ian-ross/solder-snorter/README.md

# Solder Snorter: a PC fan solder fume extractor

*Solder Snorter* is a project I used to learn a little about battery
charging and power conversion. You can read about it
[here](https://www.skybluetrades.net/projects/solder-snorter).

Designed with [KiCad](https://kicad-pcb.org/).
