ian-ross/solder-snorter/solder-snorter-bom.ods

Reference | Quantity | Order Qty | Value | Footprint | Datasheet | MPN
BT1 | 1 | 6 | Battery_Cell | solder-snorter:BatteryHolder_Keystone_54_1x18650 | https://www.mouser.at/datasheet/2/215/4-745936.pdf | Keystone 54 (x 2)
C1 C2 | 2 | 20 | 4.7U | Capacitor_SMD:C_0805_2012Metric_Pad1.15x1.40mm_HandSolder | https://www.mouser.at/datasheet/2/210/WTC_MLCC_General_Purpose-1534899.pdf | 0805X475M250CT
C3 | 1 | 20 | 2.2U | Capacitor_SMD:C_0805_2012Metric_Pad1.15x1.40mm_HandSolder | https://www.mouser.at/datasheet/2/210/WTC_MLCC_General_Purpose-1534899.pdf | 0805X225M160CT
C4 | 1 | 20 | 10U | Capacitor_SMD:C_0805_2012Metric_Pad1.15x1.40mm_HandSolder | https://www.mouser.at/datasheet/2/212/KEM_C1006_X5R_SMD-1103249.pdf | C0805C106K4PAC
D1 D2 | 2 |  | LED | LED_SMD:LED_0805_2012Metric_Pad1.15x1.40mm_HandSolder | ~
J1 | 1 | 5 | USB_B_Micro | solder-snorter:USB_Micro-B_Amphenol_10118194-0001LF | https://cdn.amphenol-icc.com/media/wysiwyg/files/drawing/10118194.pdf | 10118194-0001LF
L1 | 1 | 3 | 10U | solder-snorter:L_Murata_FDSD0420-H-100M | https://search.murata.co.jp/Ceramy/image/img/P02/J(E)TE243B-0001_FDSD0420_reference.pdf | FDSD0420-H-100M=P3
M1 | 1 | 1 | Fan | Connector_PinSocket_2.54mm:PinSocket_1x02_P2.54mm_Vertical | https://www.mouser.at/datasheet/2/670/cfm-80v-1776226.pdf | CFM-8025V-132-330
R1 | 1 | 10 | 470 | Resistor_SMD:R_0805_2012Metric_Pad1.15x1.40mm_HandSolder | https://www.mouser.at/datasheet/2/427/crcwce3-1762584.pdf | CRCW0805470RFKEAC
R2 | 1 | 10 | 2K | Resistor_SMD:R_0805_2012Metric_Pad1.15x1.40mm_HandSolder | https://www.mouser.at/datasheet/2/427/crcwce3-1762584.pdf | CRCW08052K00FKEAC
SW1 | 1 | 3 | SW_SPDT | solder-snorter:SW_SPDT_OS102011MA1QN1 | https://www.mouser.at/datasheet/2/60/os-1841429.pdf | OS102011MA1QN1
U1 | 1 | 3 | MCP73831 | Package_TO_SOT_SMD:SOT-23-5_HandSoldering | https://www.mouser.at/datasheet/2/268/20001984g-846362.pdf | MCP73831T-2ACI/OT
U2 | 1 | 3 | TLV61046A | Package_TO_SOT_SMD:SOT-23-6_Handsoldering | http://www.ti.com/general/docs/suppproductinfo.tsp?distId=26 | TLV61046ADBVR
Fix-up parts to order
RX |  | 10 | 39K | Resistor_SMD:R_0805_2012Metric_Pad1.15x1.40mm_HandSolder | https://www.mouser.at/datasheet/2/219/RK73H-1825326.pdf | RK73H2ATTDD3902F
RX |  | 10 | 27K | Resistor_SMD:R_0805_2012Metric_Pad1.15x1.40mm_HandSolder | https://www.mouser.at/datasheet/2/219/RK73H-1825326.pdf | RK73H2ATTD2702F
Non-order parts
TP1 | 1 |  | GND | TestPoint:TestPoint_Pad_2.0x2.0mm | ~
TP2 | 1 |  | VBUS | TestPoint:TestPoint_Pad_2.0x2.0mm | ~
TP3 | 1 |  | SW | TestPoint:TestPoint_Pad_2.0x2.0mm | ~
TP4 | 1 |  | VBAT | TestPoint:TestPoint_Pad_2.0x2.0mm | ~
TP5 | 1 |  | +12V | TestPoint:TestPoint_Pad_2.0x2.0mm | ~
J2 J3 | 2 |  | Conn_01x01 | MountingHole:MountingHole_4.3mm_M4_DIN965 | ~
