ian-ross/solder-snorter/solder-snorter-schematic.pdf

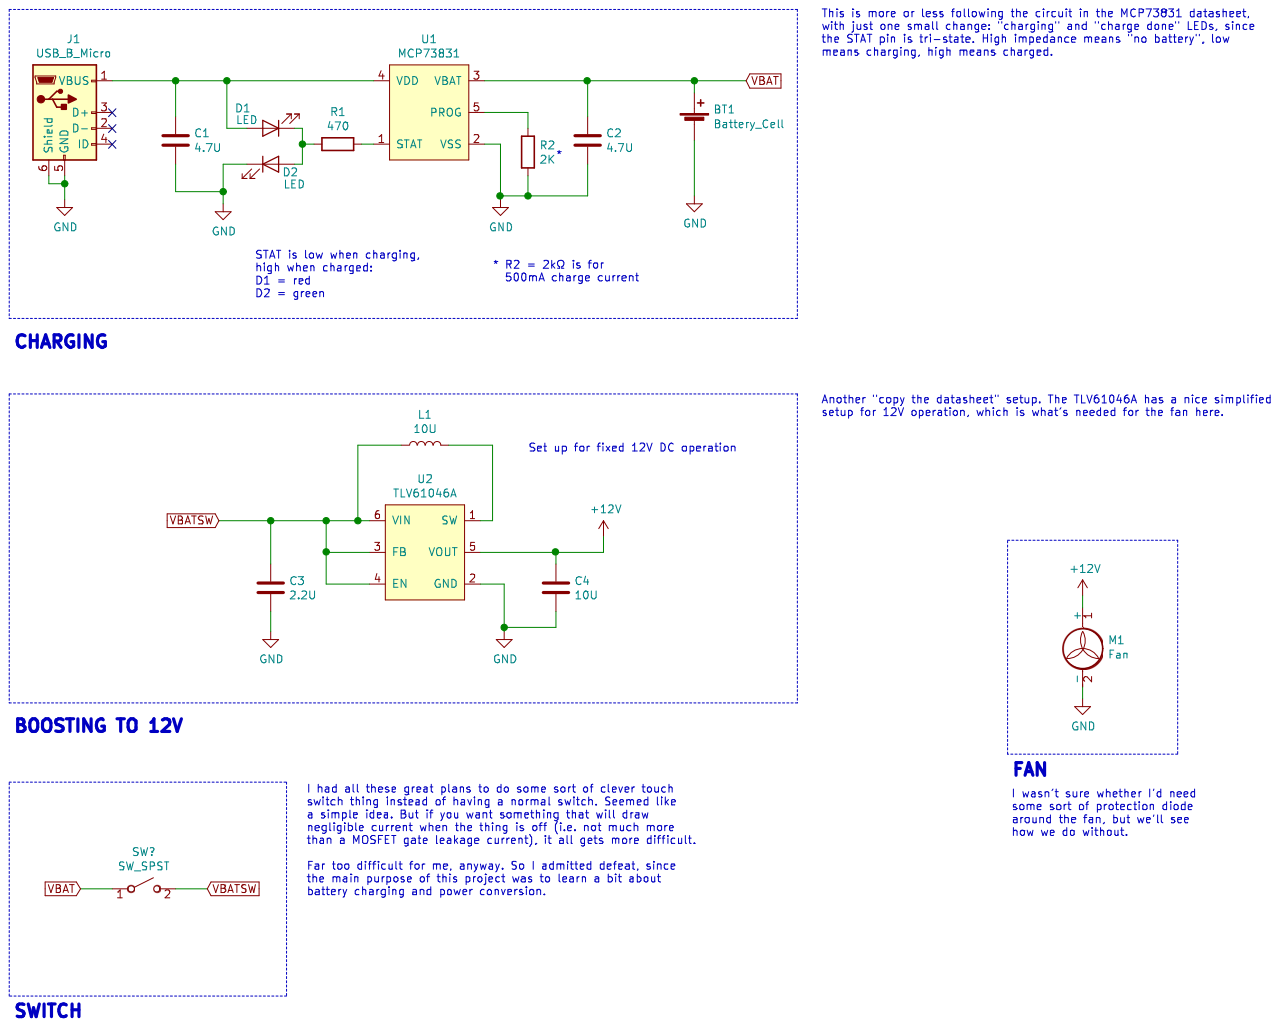
[picture p1: page 1]
