ian-ross/solder-snorter/solder-snorter.kicad_pcb

## KiCad design solder-snorter.kicad_pcb (2020-06-06)

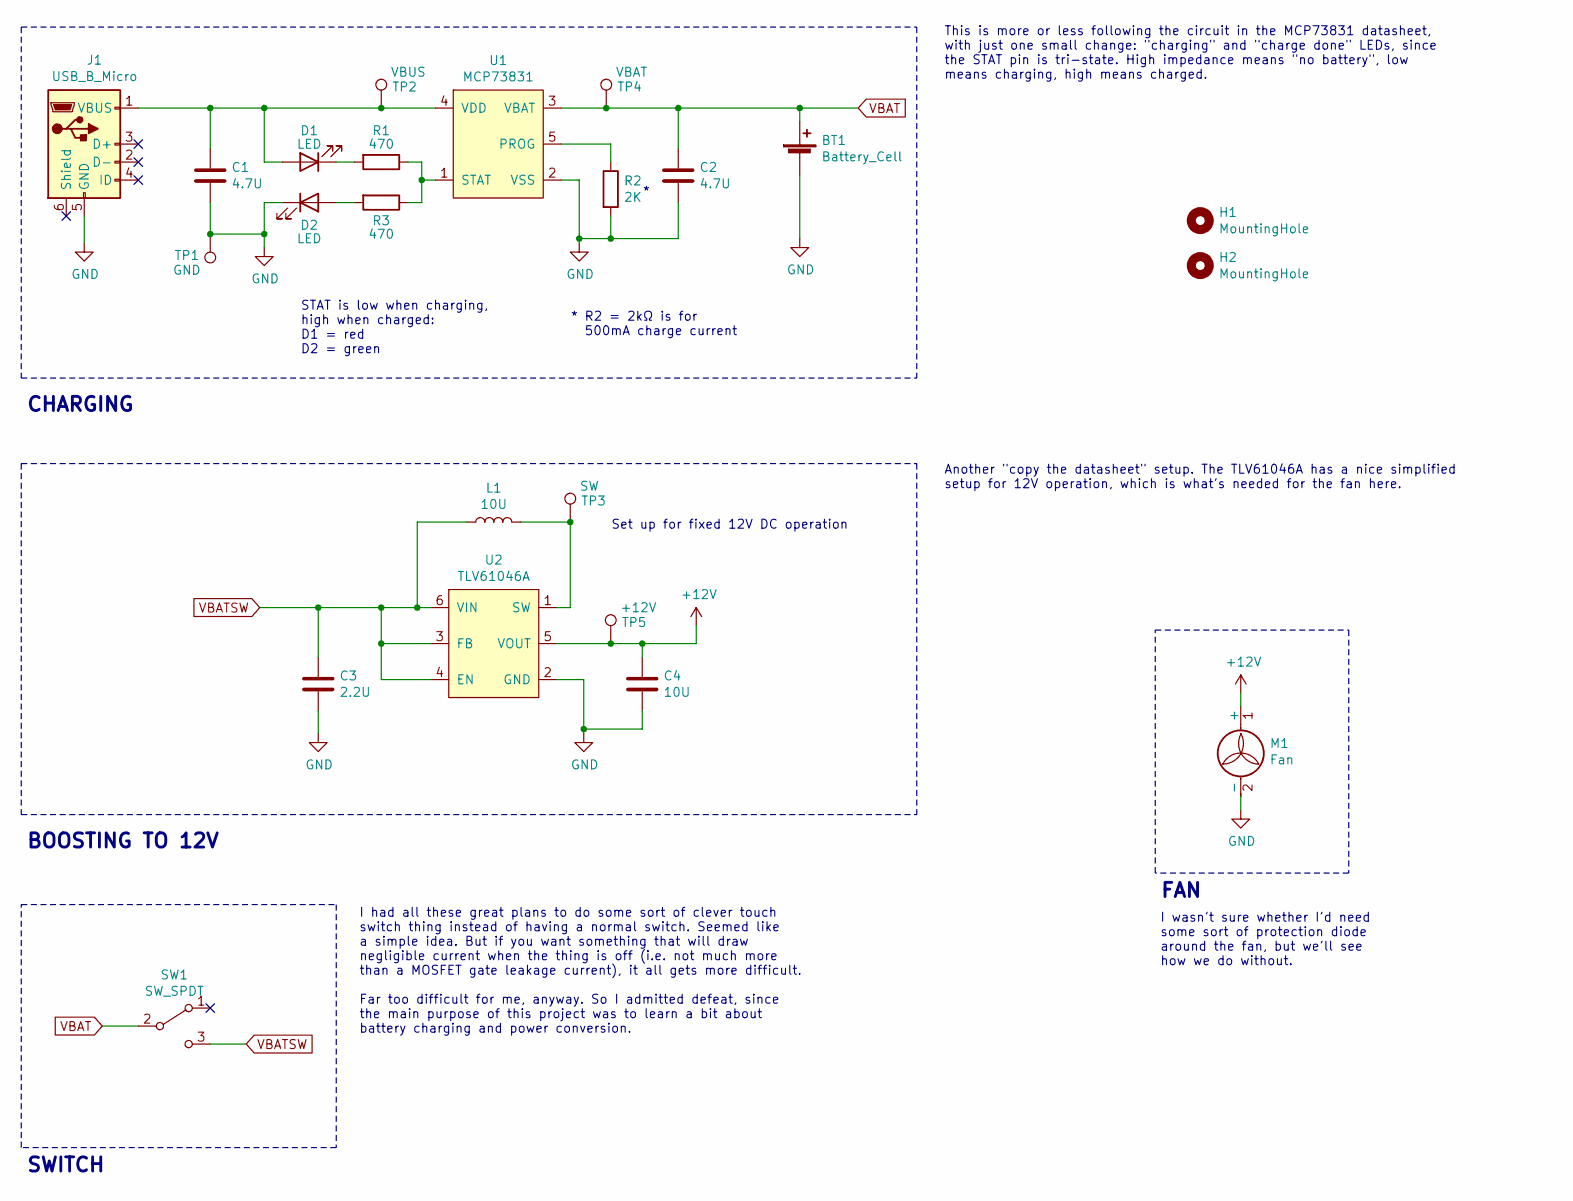
[picture p2: schematic solder-snorter.sch, Solder Snorter]

Parts:
BT1: Battery_Cell; BatteryHolder_Keystone_54_1x18650; MPN Keystone 54 (x 2)
C1, C2: 4.7U; C_0805_2012Metric_Pad1.15x1.40mm_HandSolder; MPN 0805X475M250CT
C3: 2.2U; C_0805_2012Metric_Pad1.15x1.40mm_HandSolder; MPN 0805X225M160CT
C4: 10U; C_0805_2012Metric_Pad1.15x1.40mm_HandSolder; MPN C0805C106K4PAC
D1, D2: LED; LED_0805_2012Metric_Pad1.15x1.40mm_HandSolder
H1, H2: MountingHole; MountingHole_4.3mm_M4_DIN965
J1: USB_B_Micro; USB_Micro-B_Amphenol_10118194-0001LF; MPN 10118194-0001LF
L1: 10U; L_Murata_FDSD0420-H-100M; MPN FDSD0420-H-100M=P3
M1: Fan; PinSocket_1x02_P2.54mm_Vertical; MPN CFM-8025V-132-330
R1, R3: 470; R_0805_2012Metric_Pad1.15x1.40mm_HandSolder; MPN CRCW0805470RFKEAC
R2: 2K; R_0805_2012Metric_Pad1.15x1.40mm_HandSolder; MPN CRCW08052K00FKEAC
SW1: SW_SPDT; SW_SPDT_OS102011MA1QN1; MPN OS102011MA1QN1
TP1: GND; TestPoint_Pad_2.0x2.0mm
TP2: VBUS; TestPoint_Pad_2.0x2.0mm
TP3: SW; TestPoint_Pad_2.0x2.0mm
TP4: VBAT; TestPoint_Pad_2.0x2.0mm
TP5: +12V; TestPoint_Pad_2.0x2.0mm
U1: MCP73831; SOT-23-5_HandSoldering; MPN MCP73831T-2ACI/OT
U2: TLV61046A; SOT-23-6_Handsoldering; MPN TLV61046ADBVR

Connections:
+12V: C4.1, M1.1 (+), TP5.1, U2.5 (VOUT)
GND: BT1.2 (-), C1.2, C2.2, C3.2, C4.2, D2.1 (K), J1.5 (GND), M1.2 (-), R2.2, TP1.1, U1.2 (VSS), U2.2 (GND)
unnamed: C1.1, D1.2 (A), J1.1 (VBUS), TP2.1, U1.4 (VDD)
unnamed: D1.1 (K), R1.2
unnamed: D2.2 (A), R3.2
unnamed: L1.2, TP3.1, U2.1 (SW)
unnamed: R1.1, R3.1, U1.1 (STAT)
unnamed: R2.1, U1.5 (PROG)
VBAT: BT1.1 (+), C2.1, SW1.2 (B), TP4.1, U1.3 (VBAT)
VBATSW: C3.1, L1.1, SW1.3 (C), U2.3 (FB), U2.4 (EN), U2.6 (VIN)

Notes on the sheet:
* R2 = 2kΩ is for 500mA charge current
STAT is low when charging, high when charged: D1 = red D2 = green
CHARGING
BOOSTING TO 12V
FAN
Set up for fixed 12V DC operation
SWITCH
I wasn't sure whether I'd need some sort of protection diode around the fan, but we'll see how we do without.
I had all these great plans to do some sort of clever touch switch thing instead of having a normal switch. Seemed like a simple idea. But if you want something that will draw negligible current when the thing is off (i.e. not much more than a MOSFET gate leakage current), it all gets more difficul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
This is more or less following the circuit in the MCP73831 datasheet, with just one small change: "charging" and "charge done" LEDs, since the STAT pin is tri-state. High impedance means "no battery", low means charging, high means charged.
Another "copy the datasheet" setup. The TLV61046A has a nice simplified setup for 12V operation, which is what's needed for the fan here.

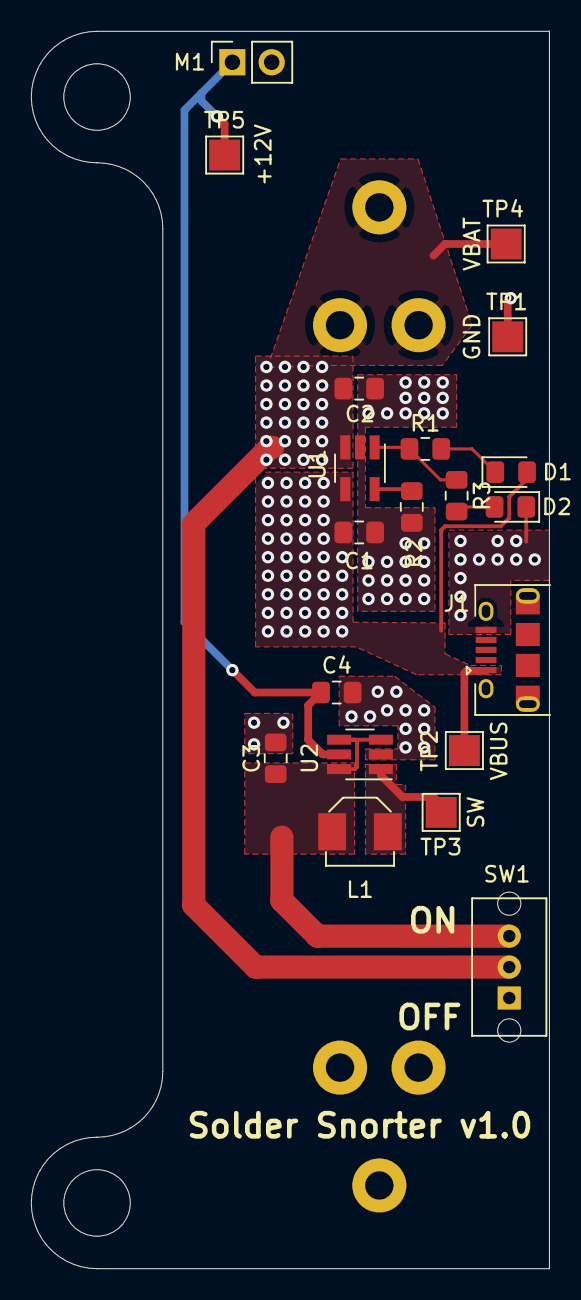
[picture p3: board solder-snorter.kicad_pcb from above]

Board: 2 copper layers, 33.5 x 80.0 mm, 23 parts (1 on the bottom side), 10 nets.
