ian-ross/solder-snorter/(commit log)

2020-05-14 Initial schematic
    [solder-snorter.kicad_pcb, solder-snorter.sch]
2020-05-17 Footprints done; layout started
    [solder-snorter.kicad_pcb, solder-snorter.sch]
2020-05-17 Finished first cut at layout
    [solder-snorter.kicad_pcb]
2020-05-18 Finished v1.0 layout
    [solder-snorter-B_Cu.gbr, solder-snorter-B_Mask.gbr, solder-snorter-B_Paste.gbr, solder-snorter-B_SilkS.gbr, solder-snorter-Edge_Cuts.gbr, solder-snorter-F_Cu.gbr, solder-snorter-F_Mask.gbr, solder-snorter-F_Paste.gbr]
2020-06-01 v1.0 finished
    [solder-snorter-bom.ods, solder-snorter.kicad_pcb, solder-snorter.sch]
2020-06-06 Fix LED resistor mistake
    [solder-snorter.kicad_pcb, solder-snorter.sch]
